re-innovation/DataLogger/PCB/DataLogger PCB v2/DataLogger_LinkItOne_PCB_v2.kicad_pcb

## KiCad design PCB/DataLogger PCB v2/DataLogger_LinkItOne_PCB_v2.kicad_pcb (2020-08-17)

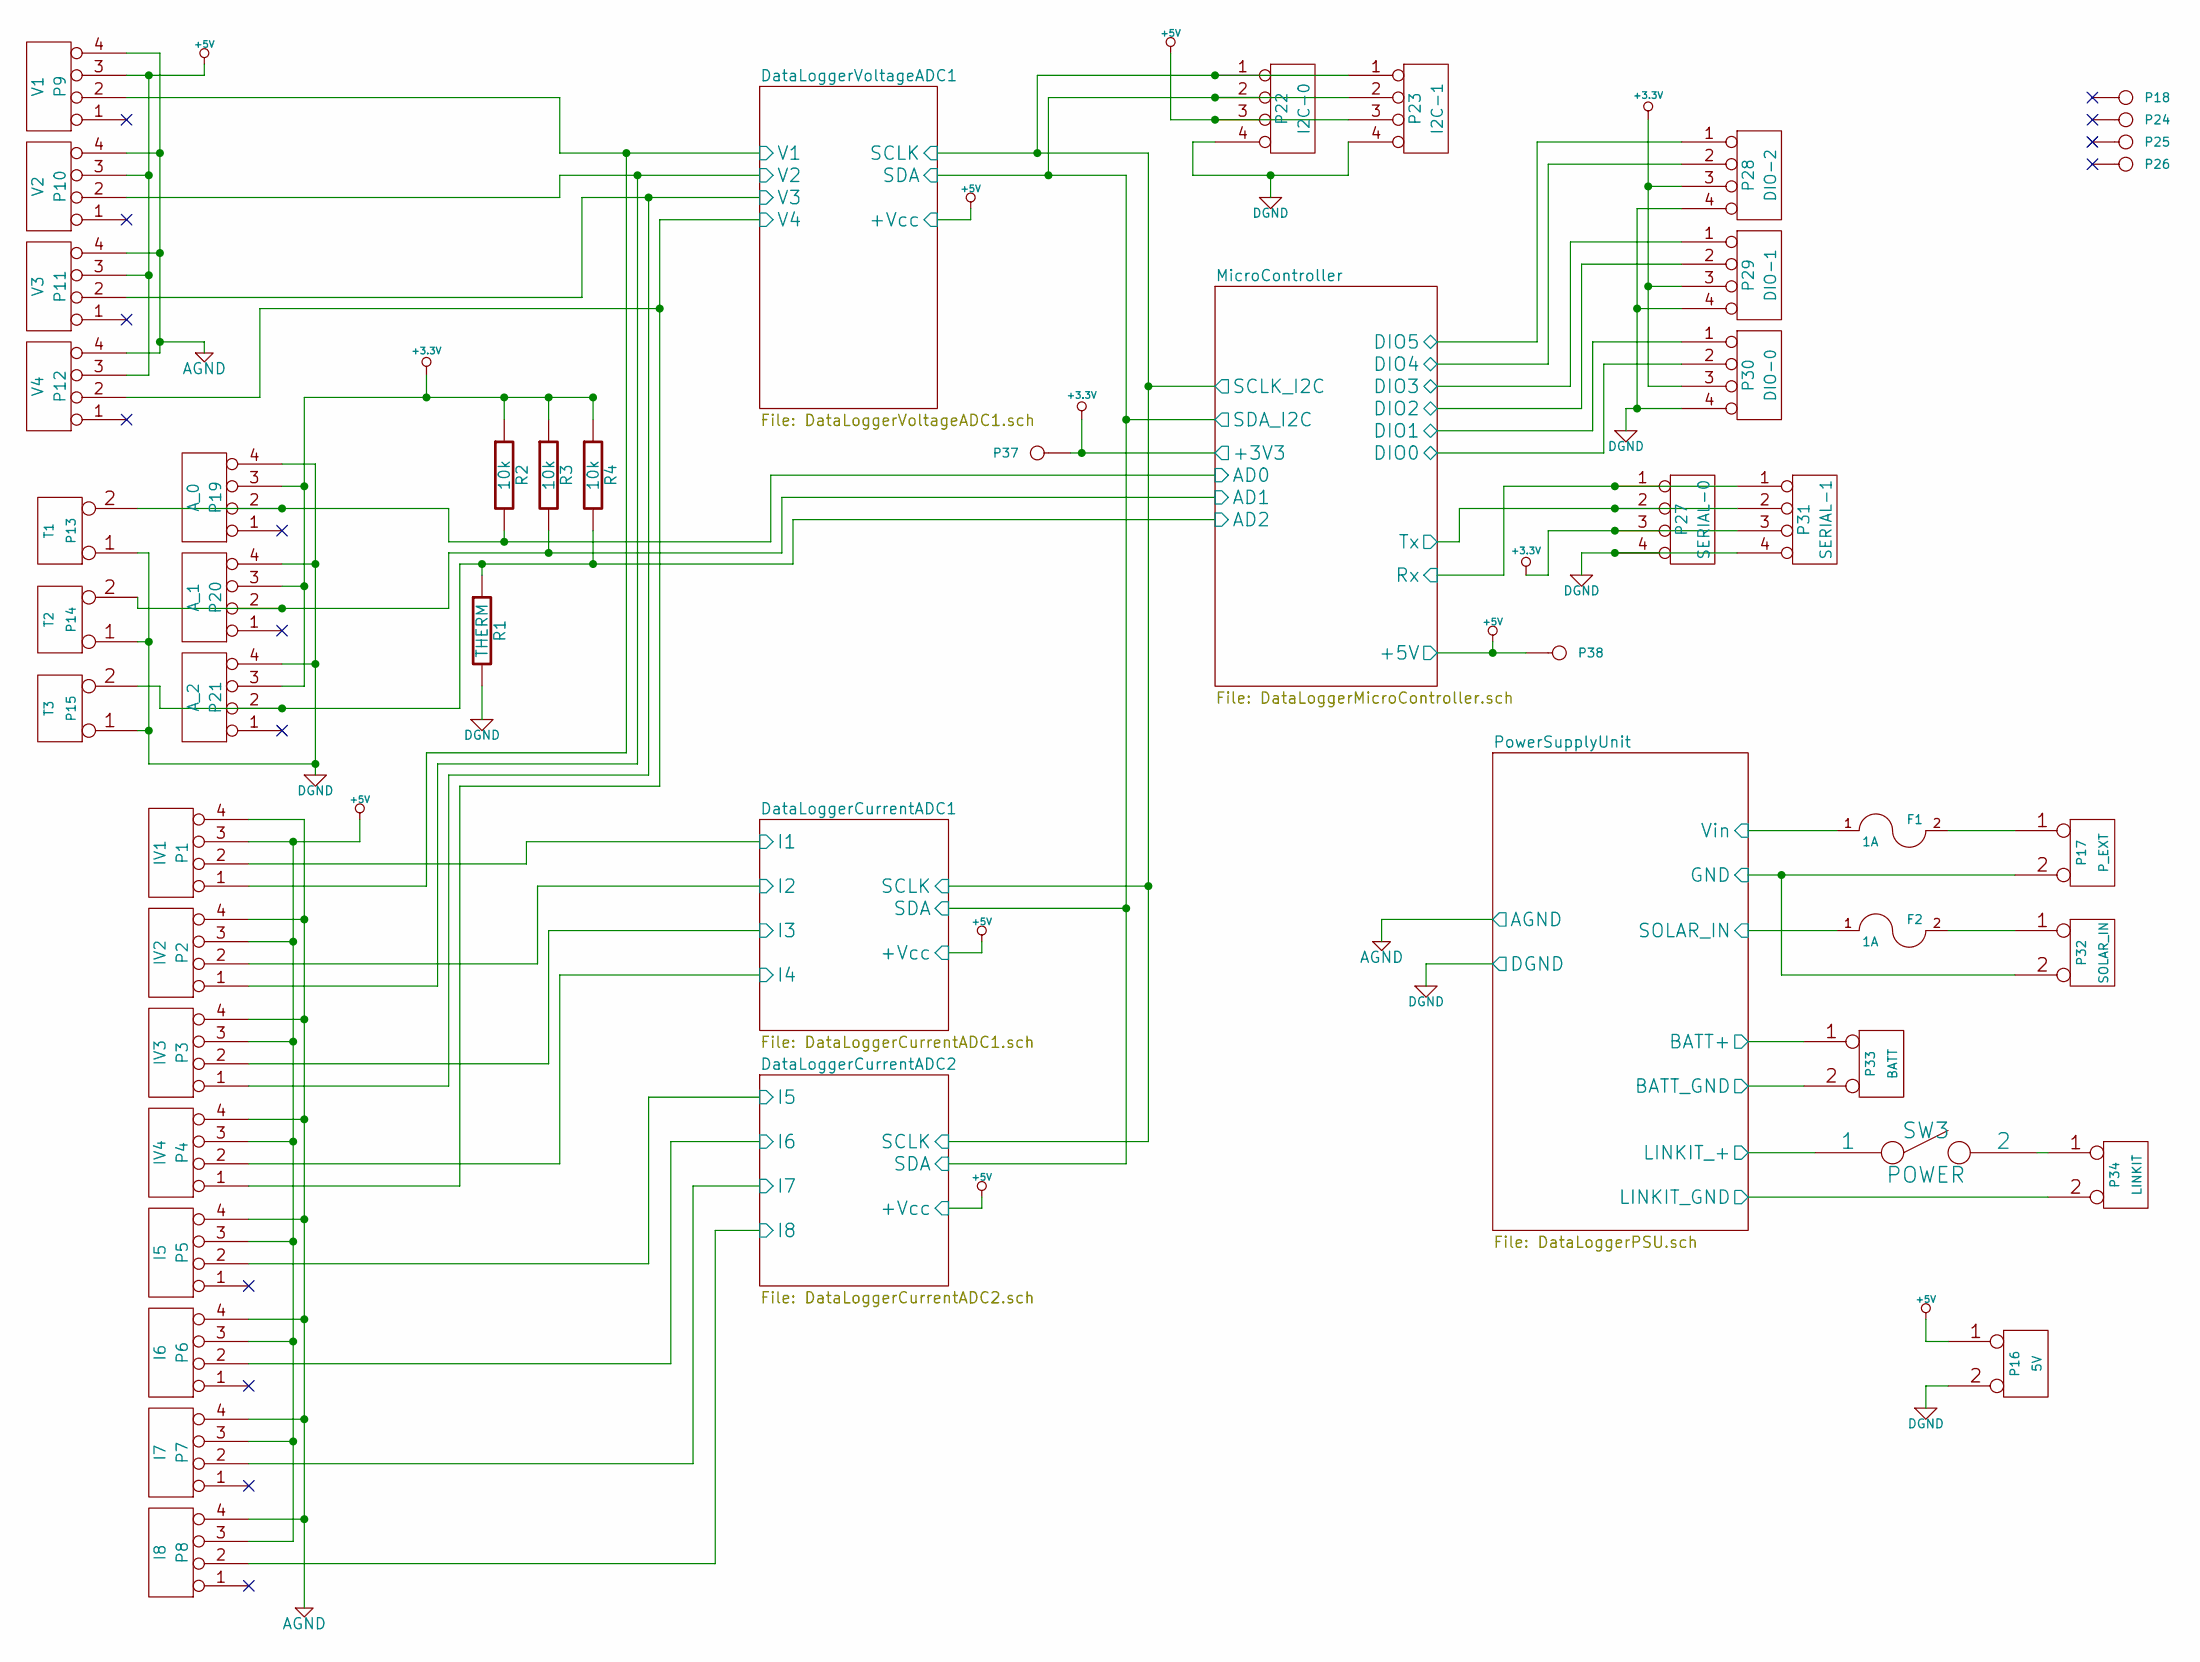
[picture p1: schematic DataLogger_LinkItOne_PCB_v2.sch, VIt Monitoring Slave Unit]

Parts:
F1, F2: 1A
P1: IV1
P2: IV2
P3: IV3
P4: IV4
P5: I5
P6: I6
P7: I7
P8: I8
P9: V1
P10: V2
P11: V3
P12: V4
P13: T1
P14: T2
P15: T3
P16: 5V
P17: P_EXT
P18, P24, P25, P26: CONN_1
P19: A_0
P20: A_1
P21: A_2
P22: I2C-0
P23: I2C-1
P27: SERIAL-0
P28: DIO-2
P29: DIO-1
P30: DIO-0
P31: SERIAL-1
P32: SOLAR_IN
P33: BATT
P34: LINKIT
P37: TP33V
P38: TP5V
R1: THERM
R2, R3, R4: 10k
SW3: POWER

Connections:
+3.3V: P19.3, P20.3, P21.3, P27.3, P28.3, P29.3, P30.3, P31.3, P37.1, R2.1, R3.1, R4.1; also elsewhere on the board
+5V: P1.3, P2.3, P3.3, P4.3, P5.3, P6.3, P7.3, P8.3, P9.3, P10.3, P11.3, P12.3, P16.1, P22.3, P23.3, P38.1; also elsewhere on the board
/DataLoggerCurrentADC1/I1: P1.2; also elsewhere on the board
/DataLoggerCurrentADC1/I2: P2.2; also elsewhere on the board
/DataLoggerCurrentADC1/I3: P3.2; also elsewhere on the board
/DataLoggerCurrentADC1/I4: P4.2; also elsewhere on the board
/DataLoggerCurrentADC1/SCLK: P22.1, P23.1; also elsewhere on the board
/DataLoggerCurrentADC1/SDA: P22.2, P23.2; also elsewhere on the board
/DataLoggerCurrentADC2/I5: P5.2; also elsewhere on the board
/DataLoggerCurrentADC2/I6: P6.2; also elsewhere on the board
/DataLoggerCurrentADC2/I7: P7.2; also elsewhere on the board
/DataLoggerCurrentADC2/I8: P8.2; also elsewhere on the board
/DataLoggerVoltageADC1/V1: P1.1, P9.2; also elsewhere on the board
/DataLoggerVoltageADC1/V2: P2.1, P10.2; also elsewhere on the board
/DataLoggerVoltageADC1/V3: P3.1, P11.2; also elsewhere on the board
/DataLoggerVoltageADC1/V4: P4.1, P12.2; also elsewhere on the board
/MicroController/AD0: P13.2 (PM), P19.2, R2.2; also elsewhere on the board
/MicroController/AD1: P14.2 (PM), P20.2, R3.2; also elsewhere on the board
/MicroController/AD2: P15.2 (PM), P21.2, R1.1, R4.2; also elsewhere on the board
/MicroController/DIO0: P30.2; also elsewhere on the board
/MicroController/DIO1: P30.1; also elsewhere on the board
/MicroController/DIO2: P29.2; also elsewhere on the board
/MicroController/DIO3: P29.1; also elsewhere on the board
/MicroController/DIO4: P28.2; also elsewhere on the board
/MicroController/DIO5: P28.1; also elsewhere on the board
/MicroController/Rx: P27.1, P31.1; also elsewhere on the board
/MicroController/Tx: P27.2, P31.2; also elsewhere on the board
/PowerSupplyUnit/BATT+: P33.1, SW3.1; also elsewhere on the board
/PowerSupplyUnit/SOLAR_IN: F2.1; also elsewhere on the board
/PowerSupplyUnit/Vin: F1.1; also elsewhere on the board
AGND: P1.4, P2.4, P3.4, P4.4, P5.4, P6.4, P7.4, P8.4, P9.4, P10.4, P11.4, P12.4; also elsewhere on the board
DGND: P13.1, P14.1, P15.1, P16.2 (PM), P17.2 (PM), P19.4, P20.4, P21.4, P22.4, P23.4, P27.4, P28.4, P29.4, P30.4, P31.4, P32.2 (PM), P33.2 (PM), P34.2 (PM), R1.2; also elsewhere on the board
unnamed: F1.2, P17.1
unnamed: P34.1, SW3.2
unnamed: F2.2, P32.1

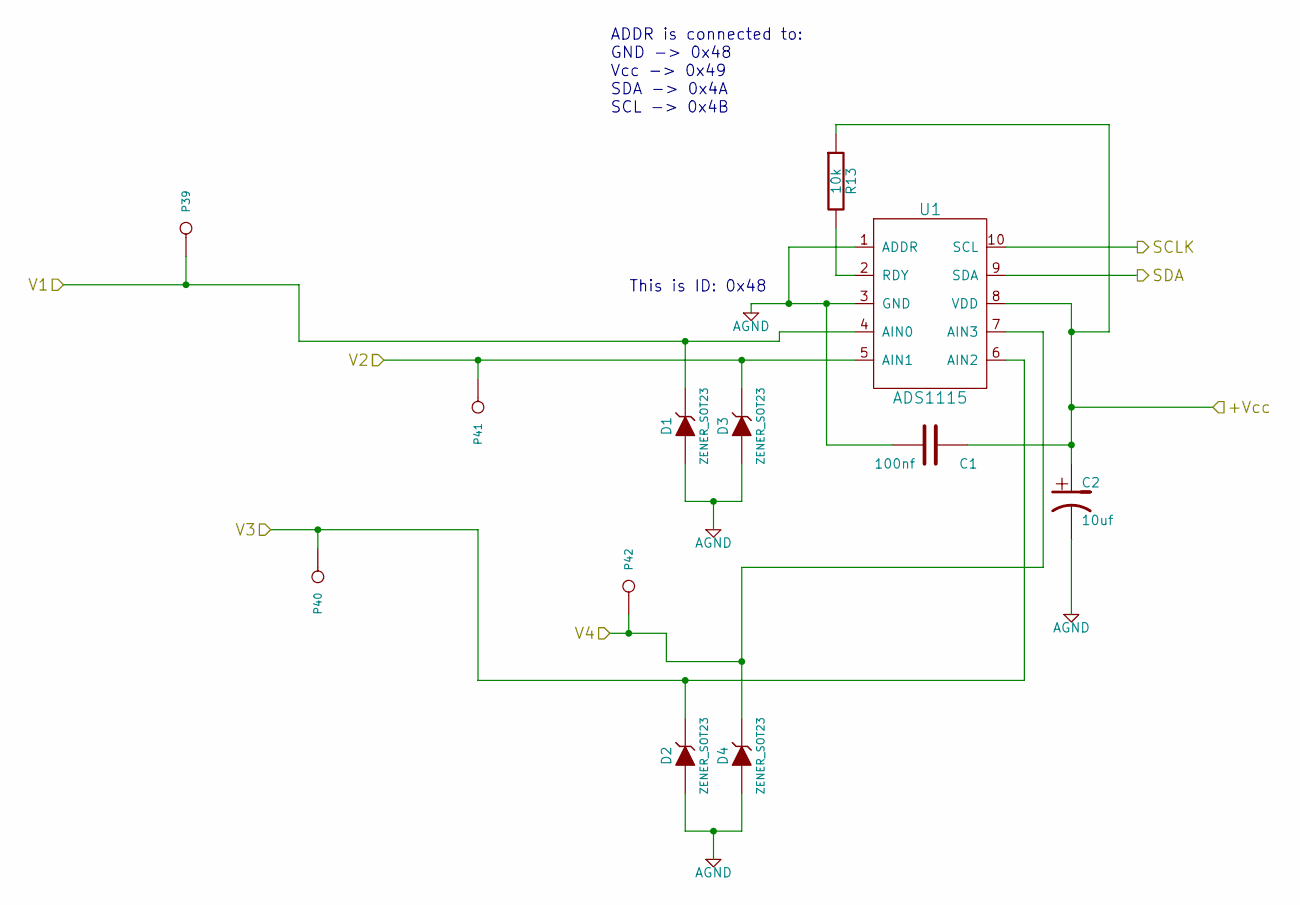
[picture p2: schematic DataLoggerVoltageADC1.sch, VIt Monitoring Slave Unit]

Parts:
C1: 100nf
C2: 10uf
D1, D2, D3, D4: ZENER_SOT23
P39: TPV1
P40: TPV3
P41: TPV2
P42: TPV4
R13: 10k
U1: ADS1115

Connections:
+5V: C1.1, C2.1, R13.1, U1.8 (VDD); also elsewhere on the board
/DataLoggerCurrentADC1/SCLK: U1.10 (SCL); also elsewhere on the board
/DataLoggerCurrentADC1/SDA: U1.9 (SDA); also elsewhere on the board
/DataLoggerVoltageADC1/V1: D1.3 (K), P39.1, U1.4 (AIN0); also elsewhere on the board
/DataLoggerVoltageADC1/V2: D3.3 (K), P41.1, U1.5 (AIN1); also elsewhere on the board
/DataLoggerVoltageADC1/V3: D2.3 (K), P40.1, U1.6 (AIN2); also elsewhere on the board
/DataLoggerVoltageADC1/V4: D4.3 (K), P42.1, U1.7 (AIN3); also elsewhere on the board
AGND: C1.2, C2.2, D1.1 (A), D2.1 (A), D3.1 (A), D4.1 (A), U1.1 (ADDR), U1.3 (GND); also elsewhere on the board
unnamed: R13.2, U1.2 (RDY)

Notes on the sheet:
ADDR is connected to: GND -> 0x48 Vcc -> 0x49 SDA -> 0x4A SCL -> 0x4B
This is ID: 0x48

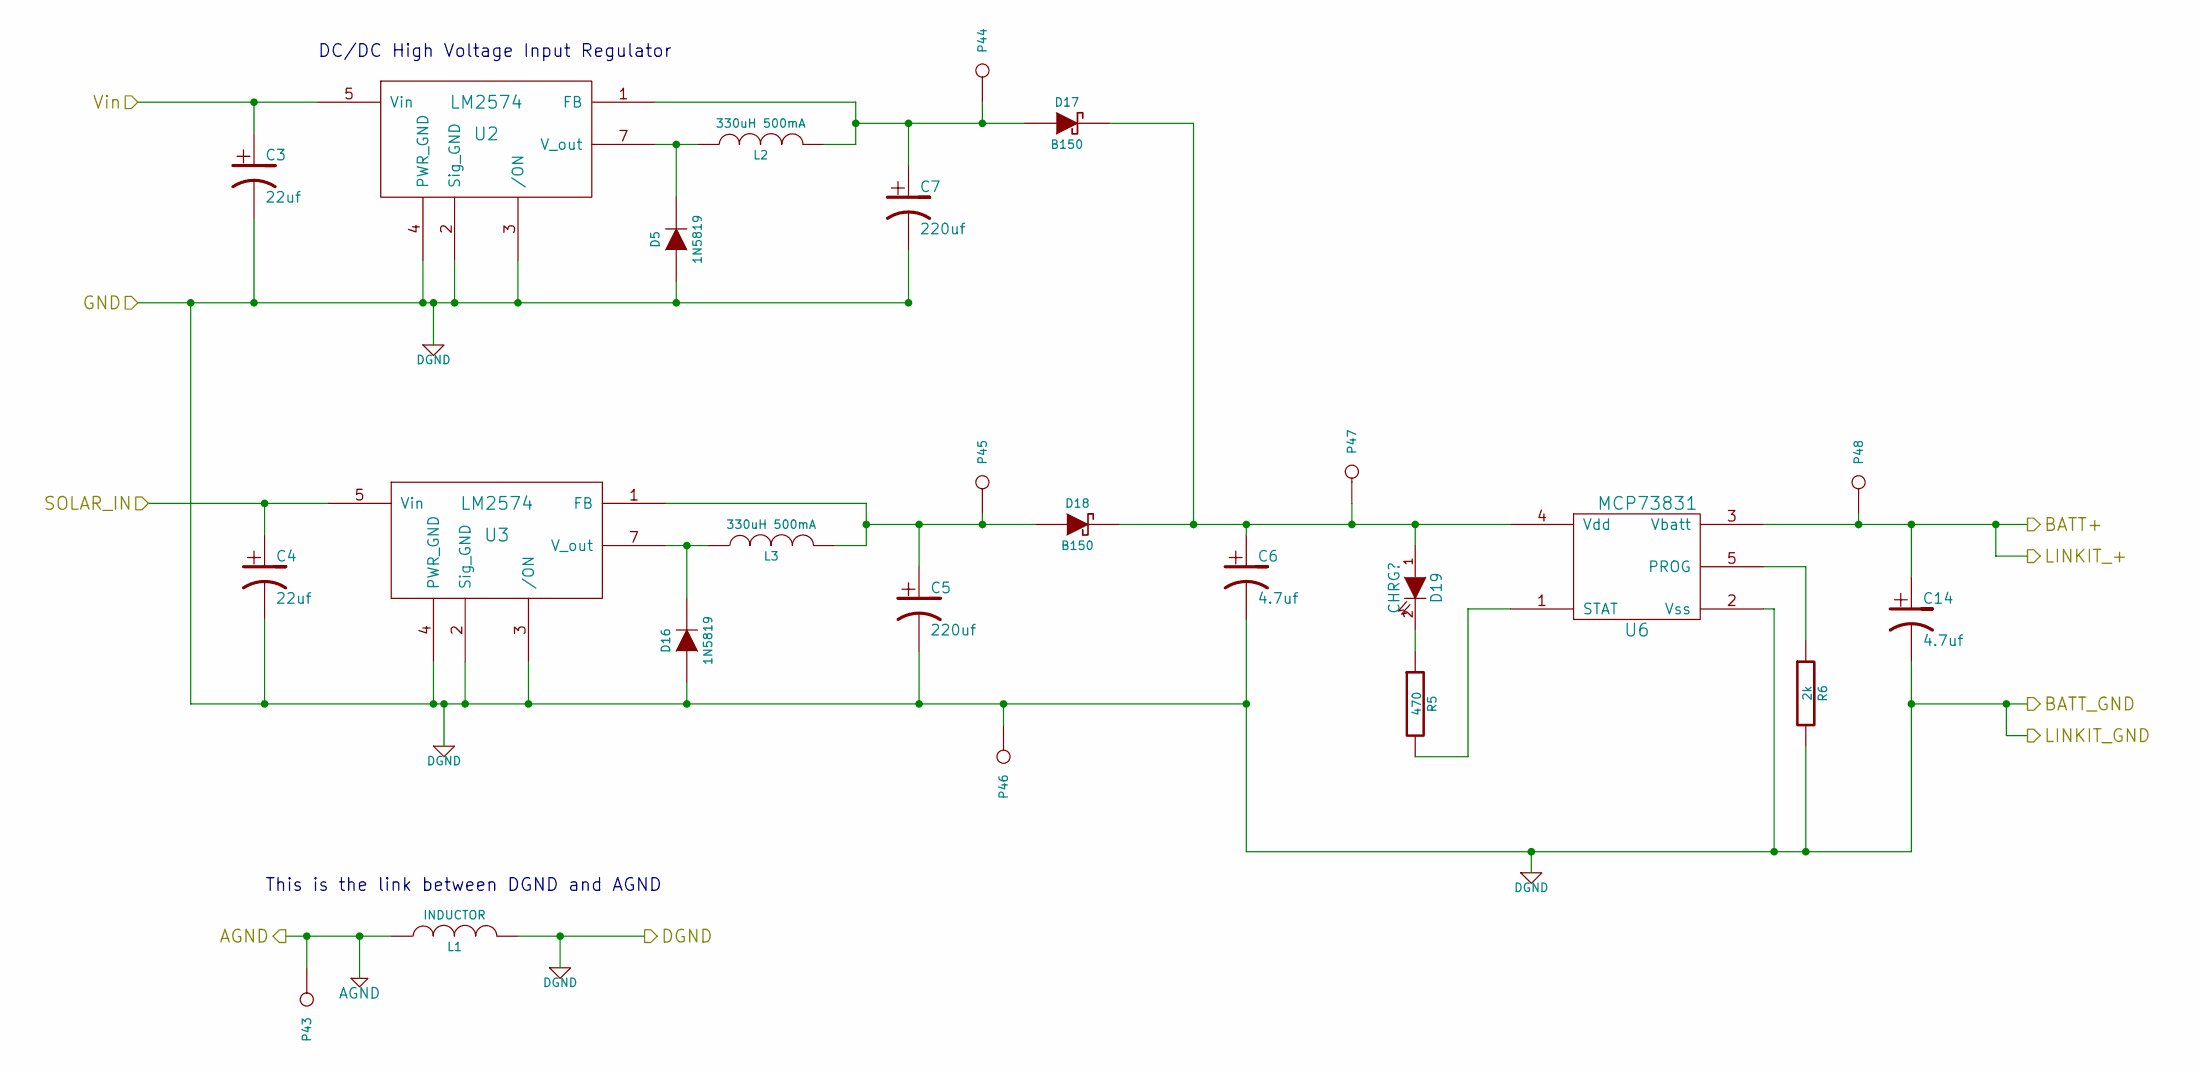
[picture p3: schematic DataLoggerPSU.sch, VIt Monitoring Slave Unit]

Parts:
C3, C4: 22uf
C5, C7: 220uf
C6, C14: 4.7uf
D5, D16: 1N5819
D17, D18: B150
D19: CHRG?
L1: INDUCTOR
L2, L3: 330uH 500mA
P43: TPAG
P44: TPP1
P45: TPP2
P46: TPDG
P47: TPP3
P48: TPBATT
R5: 470
R6: 2k
U2, U3: LM2574
U6: MCP73831

Connections:
/PowerSupplyUnit/BATT+: C14.1, P48.1, U6.3 (Vbatt); also elsewhere on the board
/PowerSupplyUnit/SOLAR_IN: C4.1, U3.5 (Vin); also elsewhere on the board
/PowerSupplyUnit/Vin: C3.1, U2.5 (Vin); also elsewhere on the board
AGND: L1.1, P43.1; also elsewhere on the board
DGND: C3.2, C4.2, C5.2, C6.2, C7.2, C14.2, D5.1 (A), D16.1 (A), L1.2, P46.1, R6.2, U2.2 (Sig_GND), U2.3 (/ON), U2.4 (PWR_GND), U3.2 (Sig_GND), U3.3 (/ON), U3.4 (PWR_GND), U6.2 (Vss); also elsewhere on the board
unnamed: R5.2, U6.1 (STAT)
unnamed: D19.2 (K), R5.1
unnamed: R6.1, U6.5 (PROG)
unnamed: D5.2 (K), L2.1, U2.7 (V_out)
unnamed: C7.1, D17.2 (A), L2.2, P44.1, U2.1 (FB)
unnamed: C6.1, D17.1 (K), D18.1 (K), D19.1 (A), P47.1, U6.4 (Vdd)
unnamed: C5.1, D18.2 (A), L3.2, P45.1, U3.1 (FB)
unnamed: D16.2 (K), L3.1, U3.7 (V_out)

Notes on the sheet:
DC/DC High Voltage Input Regulator
This is the link between DGND and AGND

Schematic: DataLoggerMicroController.sch

Parts:
C8: 10uf
C9: 100nf
D6: ERROR
D7: DATA
P35: SW2
P36: SW1
R16, R17, R20, R21: 10k
R18, R19: 1k
SHIELD1: LINKITONE_SHIELD
SW1: SW1
SW2: SW2

Connections:
+3.3V: SHIELD1.3V3; also elsewhere on the board
+5V: C8.1, C9.1, R16.1, R17.1, R20.1, R21.1, SHIELD1.5V; also elsewhere on the board
/DataLoggerCurrentADC1/SCLK: R17.2, SHIELD1.SCL (D19/SCL); also elsewhere on the board
/DataLoggerCurrentADC1/SDA: R16.2, SHIELD1.SDA (D18/SDA); also elsewhere on the board
/MicroController/AD0: SHIELD1.AD0; also elsewhere on the board
/MicroController/AD1: SHIELD1.AD1; also elsewhere on the board
/MicroController/AD2: SHIELD1.AD2; also elsewhere on the board
/MicroController/DIO0: SHIELD1.8; also elsewhere on the board
/MicroController/DIO1: SHIELD1.9; also elsewhere on the board
/MicroController/DIO2: SHIELD1.10; also elsewhere on the board
/MicroController/DIO3: SHIELD1.11 (11/MOSI); also elsewhere on the board
/MicroController/DIO4: SHIELD1.12 (12/MISO); also elsewhere on the board
/MicroController/DIO5: SHIELD1.13 (13/SCK); also elsewhere on the board
/MicroController/Rx: SHIELD1.0 (0/Rx); also elsewhere on the board
/MicroController/Tx: SHIELD1.1 (1/Tx); also elsewhere on the board
DGND: C8.2, C9.2, P35.2 (PM), P36.2 (PM), R18.2, R19.2, SHIELD1.GND1, SHIELD1.GND2, SW1.2, SW2.1; also elsewhere on the board
unnamed: D6.2, R18.1
unnamed: D7.2, R19.1
unnamed: D6.1, SHIELD1.4
unnamed: D7.1, SHIELD1.5
unnamed: P36.1, R20.2, SHIELD1.6, SW1.1
unnamed: P35.1, R21.2, SHIELD1.7, SW2.2

Notes on the sheet:
I2C BUS

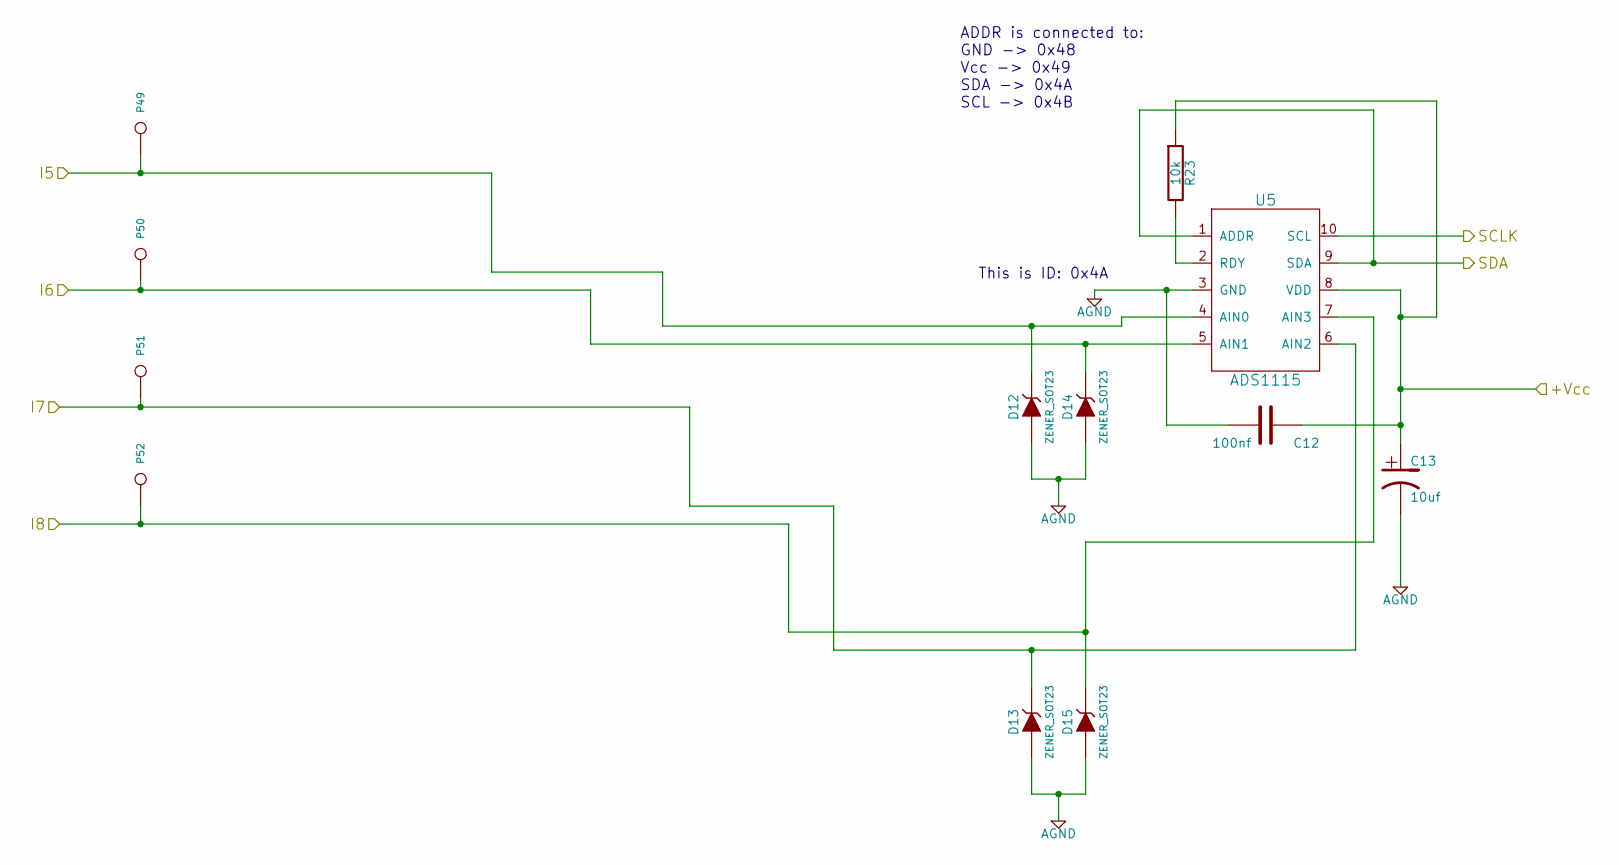
[picture p4: schematic DataLoggerCurrentADC2.sch, VIt Monitoring Slave Unit]

Parts:
C12: 100nf
C13: 10uf
D12, D13, D14, D15: ZENER_SOT23
P49: TPI5
P50: TPI6
P51: TPI7
P52: TPI8
R23: 10k
U5: ADS1115

Connections:
+5V: C12.1, C13.1, R23.1, U5.8 (VDD); also elsewhere on the board
/DataLoggerCurrentADC1/SCLK: U5.10 (SCL); also elsewhere on the board
/DataLoggerCurrentADC1/SDA: U5.1 (ADDR), U5.9 (SDA); also elsewhere on the board
/DataLoggerCurrentADC2/I5: D12.3 (K), P49.1, U5.4 (AIN0); also elsewhere on the board
/DataLoggerCurrentADC2/I6: D14.3 (K), P50.1, U5.5 (AIN1); also elsewhere on the board
/DataLoggerCurrentADC2/I7: D13.3 (K), P51.1, U5.6 (AIN2); also elsewhere on the board
/DataLoggerCurrentADC2/I8: D15.3 (K), P52.1, U5.7 (AIN3); also elsewhere on the board
AGND: C12.2, C13.2, D12.1 (A), D13.1 (A), D14.1 (A), D15.1 (A), U5.3 (GND); also elsewhere on the board
unnamed: R23.2, U5.2 (RDY)

Notes on the sheet:
ADDR is connected to: GND -> 0x48 Vcc -> 0x49 SDA -> 0x4A SCL -> 0x4B
This is ID: 0x4A

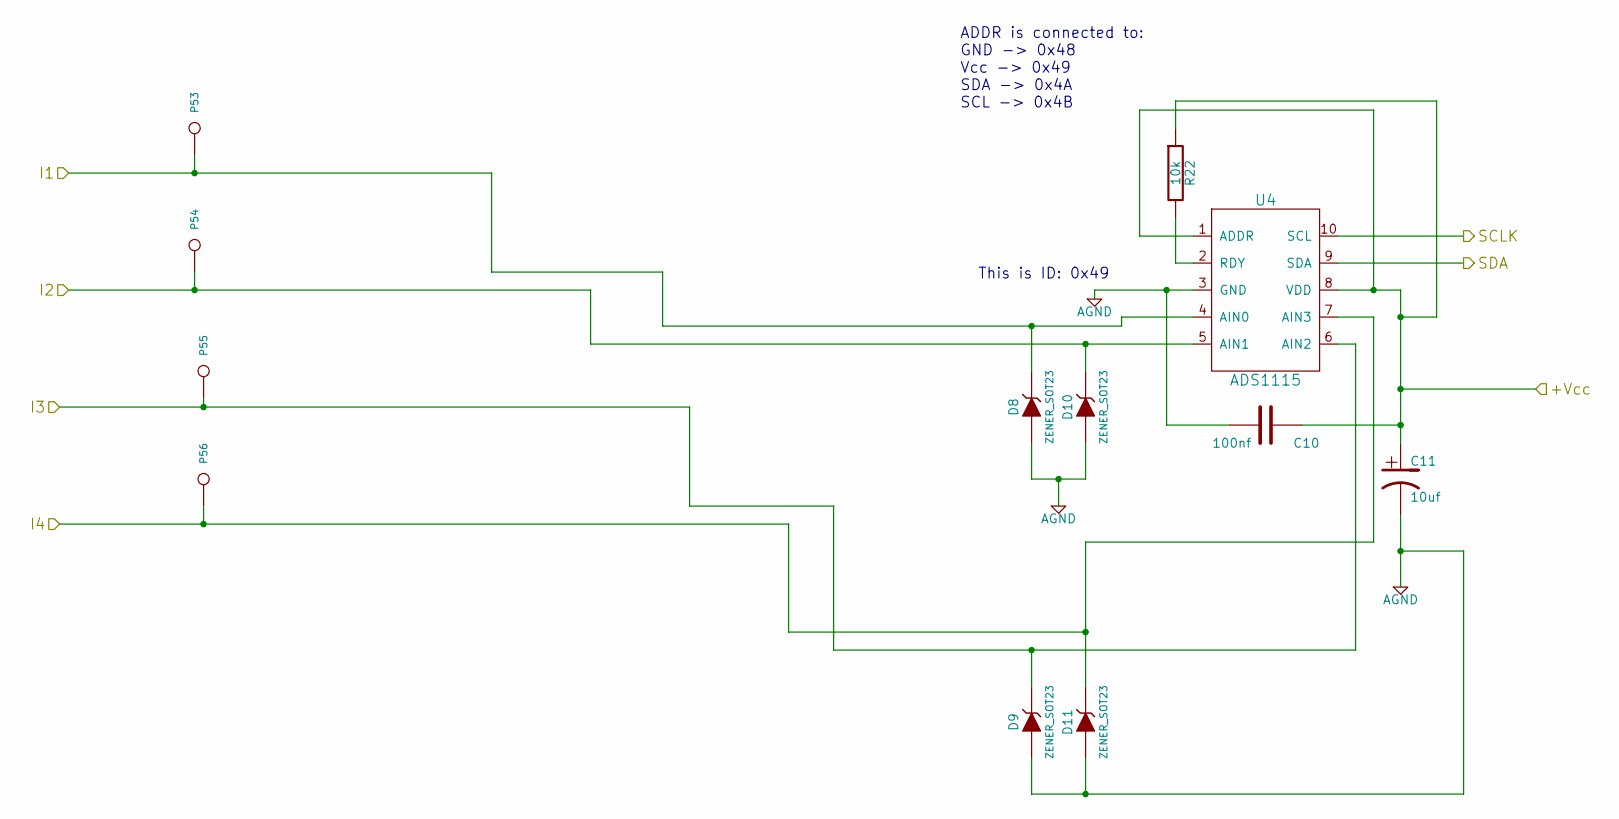
[picture p5: schematic DataLoggerCurrentADC1.sch, VIt Monitoring Slave Unit]

Parts:
C10: 100nf
C11: 10uf
D8, D9, D10, D11: ZENER_SOT23
P53: TPI1
P54: TPI2
P55: TPI3
P56: TPI4
R22: 10k
U4: ADS1115

Connections:
+5V: C10.1, C11.1, R22.1, U4.1 (ADDR), U4.8 (VDD); also elsewhere on the board
/DataLoggerCurrentADC1/I1: D8.3 (K), P53.1, U4.4 (AIN0); also elsewhere on the board
/DataLoggerCurrentADC1/I2: D10.3 (K), P54.1, U4.5 (AIN1); also elsewhere on the board
/DataLoggerCurrentADC1/I3: D9.3 (K), P55.1, U4.6 (AIN2); also elsewhere on the board
/DataLoggerCurrentADC1/I4: D11.3 (K), P56.1, U4.7 (AIN3); also elsewhere on the board
/DataLoggerCurrentADC1/SCLK: U4.10 (SCL); also elsewhere on the board
/DataLoggerCurrentADC1/SDA: U4.9 (SDA); also elsewhere on the board
AGND: C10.2, C11.2, D8.1 (A), D9.1 (A), D10.1 (A), D11.1 (A), U4.3 (GND); also elsewhere on the board
unnamed: R22.2, U4.2 (RDY)

Notes on the sheet:
ADDR is connected to: GND -> 0x48 Vcc -> 0x49 SDA -> 0x4A SCL -> 0x4B
This is ID: 0x49

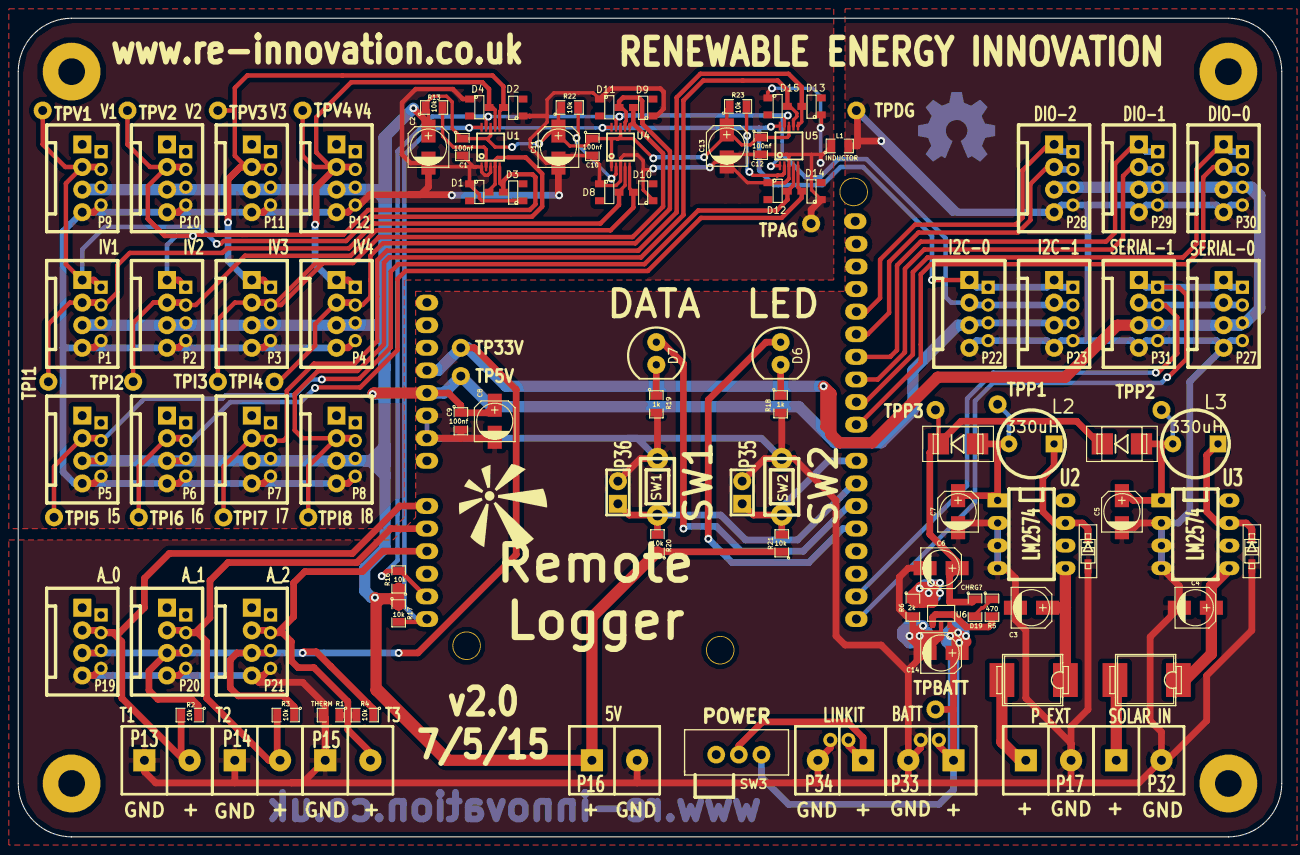
[picture p6: board DataLogger_LinkItOne_PCB_v2.kicad_pcb from above]

Board: 2 copper layers, 142.0 x 92.0 mm, 121 parts (0 on the bottom side), 52 nets.

Other parts of the board:
VAL: reinnovation_logo_15mm
VAL#2: OSHW_logo_small_back
