re-innovation/DataLogger/LinkItONE.CrestRTC/app.h

#ifndef _APP_H_
#define _APP_H_

#define HEARTBEAT_LED_PIN (5)
#define ERROR_LED_PIN (4)

void APP_SetDebugModules(char const * const modules);
void APP_DisableModules(char const * const modules);

#endif
