re-innovation/DataLogger/(commit log)

2015-02-20 Added mocks for i2c and delay
2015-02-27 Various fixes for arduino compatibility
2015-03-05 Removed STL usage from security module
2015-03-13 Added new example application (Thingspeak & ADC)
2015-04-01 Fixed Arduino example applications
2015-04-04 WIP Sensor library additions
2015-04-06 Thermistor library
2015-04-06 Completed thermistor example
2015-04-06 Fixed CSV read/write bug
    [LinkItONE.Crest.ino]
2015-04-20 Settings now accepts spaces and comments. Also has better error handling
    [app.sd_storage.cpp]
2015-04-22 Fixed all example applications
    [LinkItONE.Crest.ino]
2015-04-23 Added lots of mocks for arduino apps
2015-04-23 Mock correctly exits from fatal error
    [app.sd_storage.cpp, app.sd_storage.h]
2015-04-25 Lots of work on setup and error detection
    [app.data.cpp, app.h, app.sd_storage.cpp]
2015-04-30 Fixed off-by-one issue with adding conversions to fields
    [LinkItONE.Crest.ino, app.data.cpp]
2015-05-01 Added thermistor highside/lowside selection
2015-05-28 Changed ADC read period to 200ms (from 100ms)
2015-05-28 Fixed LED pin allocations and pinMode settings
    [LinkItONE.Crest.ino]
2015-06-01 Added battery level SMS to application
2015-06-05 Completed battery SMS warning functionality
2015-06-05 Simplified test for highside thermistor setting
2015-06-27 Thermistor fix
2015-07-03 Added error LED blinks
    [LinkItONE.Crest.ino, app.data.cpp, app.h, app.sd_storage.cpp, app.sms.cpp]
2015-07-14 Added tests for errors module
    [LinkItONE.Crest.ino, app.data.cpp, app.error.cpp, app.h, app.sd_storage.cpp, app.sms.cpp]
2015-07-15 Finished Crest error handling
    [LinkItONE.Crest.ino, app.error.cpp, app.h]
2015-07-24 Added SD card not present error
    [LinkItONE.Crest.ino, app.data.cpp, app.sd_storage.cpp]
2015-08-27 Fix for data manager issue (storing data in wrong fields)
    [app.data.cpp]
2015-08-27 Fixed failing sensor test
2015-10-02 Added offset and multiplier for voltage channels
2016-01-15 Added simple ADC example
2016-01-15 ADC and local storage bought up to date
2018-02-17 Added PCB design to the software
    [DataLoggerADC1.sch, DataLoggerADC2.sch, DataLoggerADC3.sch, DataLoggerCurrentADC1.sch, DataLoggerCurrentADC2.sch, DataLoggerCurrentADC3.sch, DataLoggerCurrentADC4.sch, DataLoggerMAX485.sch]
2020-08-17 Adding CREST logger files which work!
    [DataLogger_LinkItOne_PCB_v2.brd, DataLogger_LinkItOne_PCB_v2.kicad_pcb, DataLogger_LinkItOne_PCB_v2_SAVED.sch]
